JenFa12/hs_sensorbox/README.md

# hs_sensorbox
This is a sensorbox for home assistant
