JenFa12/hs_sensorbox/PCB/Manufactoring/Sensorbox-User_1.dxf

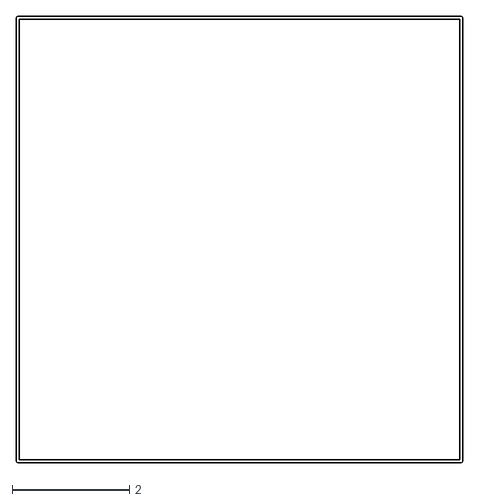
[picture p1: CAD file, 2024-02-17]
PCB/Manufactoring/Sensorbox-User_1.dxf
7.62 x 7.61
