JenFa12/hs_sensorbox/(list of files, cad)

Other CAD files:
PCB/Manufactoring/Sensorbox-F_Mask.dwg
PCB/Manufactoring/Sensorbox-B_Mask.dxf
PCB/Manufactoring/Sensorbox-F_Mask.dxf
