JenFa12/hs_sensorbox/PCB/Sensorbox.kicad_pcb

## KiCad design PCB/Sensorbox.kicad_pcb (2024-02-17)

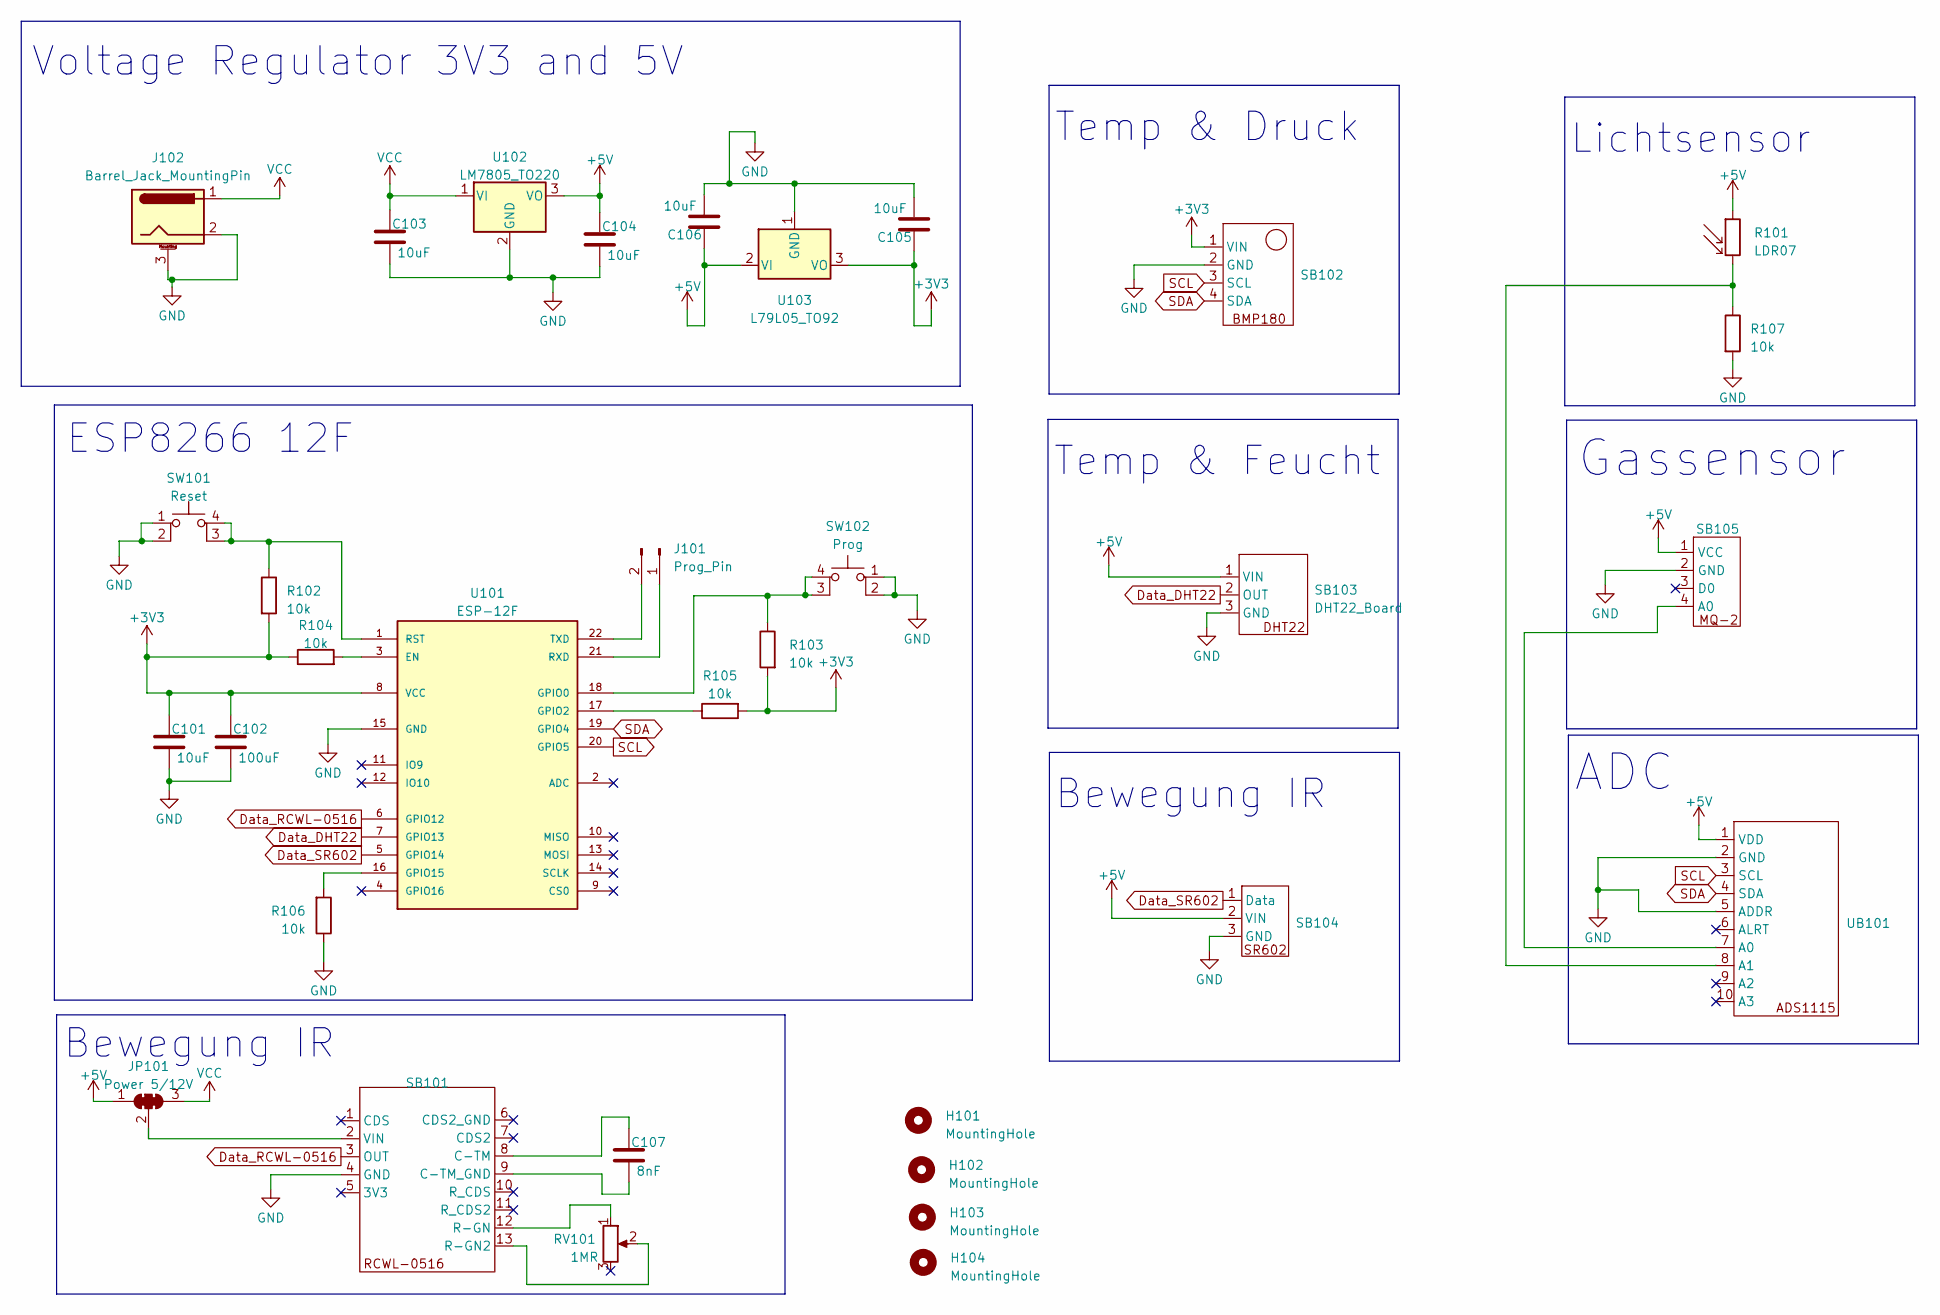
[picture p2: schematic Sensorbox.kicad_sch]

Parts:
C101, C103, C104, C105, C106: 10uF; C_0805_2012Metric_Pad1.18x1.45mm_HandSolder
C102: 100uF; C_0805_2012Metric_Pad1.18x1.45mm_HandSolder
C107: 8nF; C_0805_2012Metric_Pad1.18x1.45mm_HandSolder
H101, H102, H103, H104: MountingHole; MountingHole_3.2mm_M3
J101: Prog_Pin; PinHeader_1x02_P1.27mm_Vertical
J102: Barrel_Jack_MountingPin; BarrelJack_GCT_DCJ200-10-A_Horizontal
JP101: Power 5/12V; SolderJumper-3_P1.3mm_Open_RoundedPad1.0x1.5mm_NumberLabels
R101: LDR07; R_LDR_5.1x4.3mm_P3.4mm_Vertical
R102, R103, R104, R105, R106, R107: 10k; R_0805_2012Metric_Pad1.20x1.40mm_HandSolder
RV101: 1MR; Potentiometer_Bourns_3386F_Vertical
SB101: RCWL-0516
SB102: BMP180
SB103: DHT22_Board; DHT22-horizontal
SB104: SR602_Board
SB105: MQ-2
SW101: Reset; Button
SW102: Prog; Button
U101: ESP-12F
U102: LM7805_TO220; TO-220-3_Vertical
U103: L79L05_TO92; TO-92_Inline
UB101: ADC1115_Board

Connections:
+3V3: C101.1, C102.1, C105.1, R102.2, R103.2, R104.1, R105.2, SB102.1 (VIN), U101.8 (VCC), U103.3 (VO)
+5V: C104.1, C106.1, JP101.1 (A), R101.1, SB103.1 (VIN), SB104.2 (VIN), SB105.1 (VCC), U102.3 (VO), U103.2 (VI), UB101.1 (VDD)
Data_DHT22: SB103.2 (OUT), U101.7 (GPIO13)
Data_RCWL-0516: SB101.3 (OUT), U101.6 (GPIO12)
Data_SR602: SB104.1 (Data), U101.5 (GPIO14)
GND: C101.2, C102.2, C103.2, C104.2, C105.2, C106.2, J102.2, J102.3 (MountPin), R106.1, R107.2, SB101.4 (GND), SB102.2 (GND), SB103.3 (GND), SB104.3 (GND), SB105.2 (GND), SW101.1, SW101.2, SW102.1, SW102.2, U101.15 (GND), U102.2 (GND), U103.1 (GND), UB101.2 (GND), UB101.5 (ADDR)
unnamed: J101.1, U101.21 (RXD)
unnamed: J101.2, U101.22 (TXD)
unnamed: JP101.2 (C), SB101.2 (VIN)
unnamed: C107.1, SB101.8 (C-TM)
unnamed: C107.2, SB101.9 (C-TM_GND)
unnamed: RV101.2, SB101.13 (R-GN2)
unnamed: RV101.1, SB101.12 (R-GN)
unnamed: SB105.4 (A0), UB101.7 (A0)
unnamed: R102.1, SW101.3 (K), SW101.4 (A), U101.1 (RST)
unnamed: R103.1, SW102.3 (K), SW102.4 (A), U101.18 (GPIO0)
unnamed: R104.2, U101.3 (EN)
unnamed: R105.1, U101.17 (GPIO2)
unnamed: R106.2, U101.16 (GPIO15)
unnamed: R101.2, R107.1, UB101.8 (A1)
SCL: SB102.3 (SCL), U101.20 (GPIO5), UB101.3 (SCL)
SDA: SB102.4 (SDA), U101.19 (GPIO4), UB101.4 (SDA)
VCC: C103.1, J102.1, JP101.3 (B), U102.1 (VI)

Notes on the sheet:
ESP8266 12F
Lichtsensor
Temp & Druck
Voltage Regulator 3V3 and 5V
ADC
Bewegung IR
Temp & Feucht
Gassensor

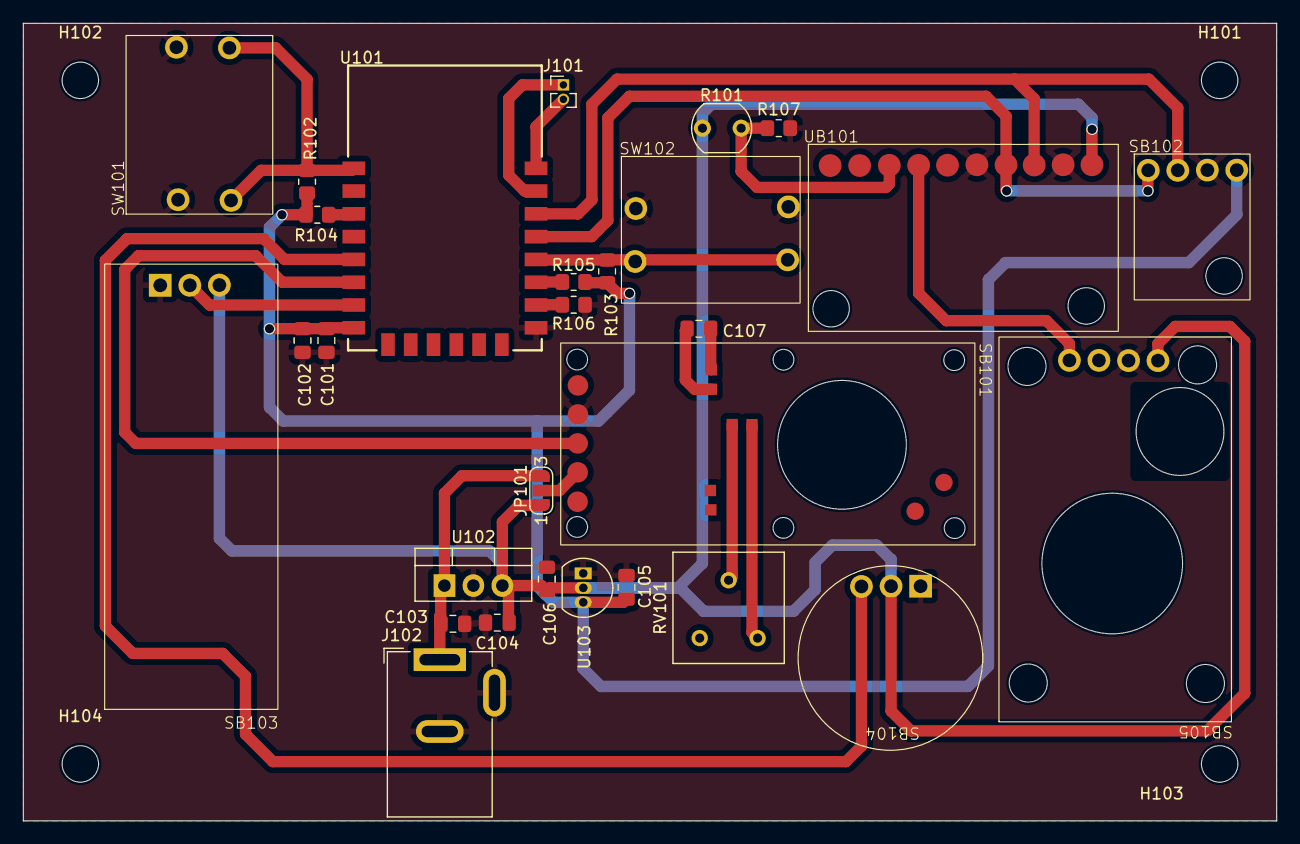
[picture p3: board Sensorbox.kicad_pcb from above]

Board: 2 copper layers, 110.0 x 70.0 mm, 33 parts (0 on the bottom side), 23 nets.
