JenFa12/hs_sensorbox/(commit log)

2024-01-17 added esp code and pcb
    [Sensorbox.kicad_pcb, Sensorbox.kicad_sch]
2024-01-25 added drill files
    [Sensorbox-B_Mask.dxf, Sensorbox-F_Mask.dwg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]
2024-01-25 'Changed speed for the drill files
2024-01-27 alignmnent holes 5mm
    [Sensorbox.kicad_pcb]
2024-02-05 added iso routing
    [Sensorbox.kicad_pcb]
2024-02-05 added ncc for front plate
2024-02-06 added in board cutouts
    [Sensorbox-NPTH.drl, Sensorbox-PTH.drl, Sensorbox-User_1.gbr, Sensorbox-job.gbrjob]
2024-02-06 chenget cut depth from 1 to multi depth
2024-02-06 added back trace
2024-02-06 added back trace2
2024-02-17 deleted all FlatCam files
    [Sensorbox-B_Mask.dxf, Sensorbox-F_Mask.dxf, Sensorbox-User_1.dxf, Sensorbox.kicad_pcb]
2024-02-21 added new ncc file for front
    [Sensorbox-B_Mask.dxf, Sensorbox-F_Mask.dxf]
